shb-png/ece-362-project/ece-362-project-pcb.kicad_pcb

## KiCad design ece-362-project-pcb.kicad_pcb (2026-11-06)

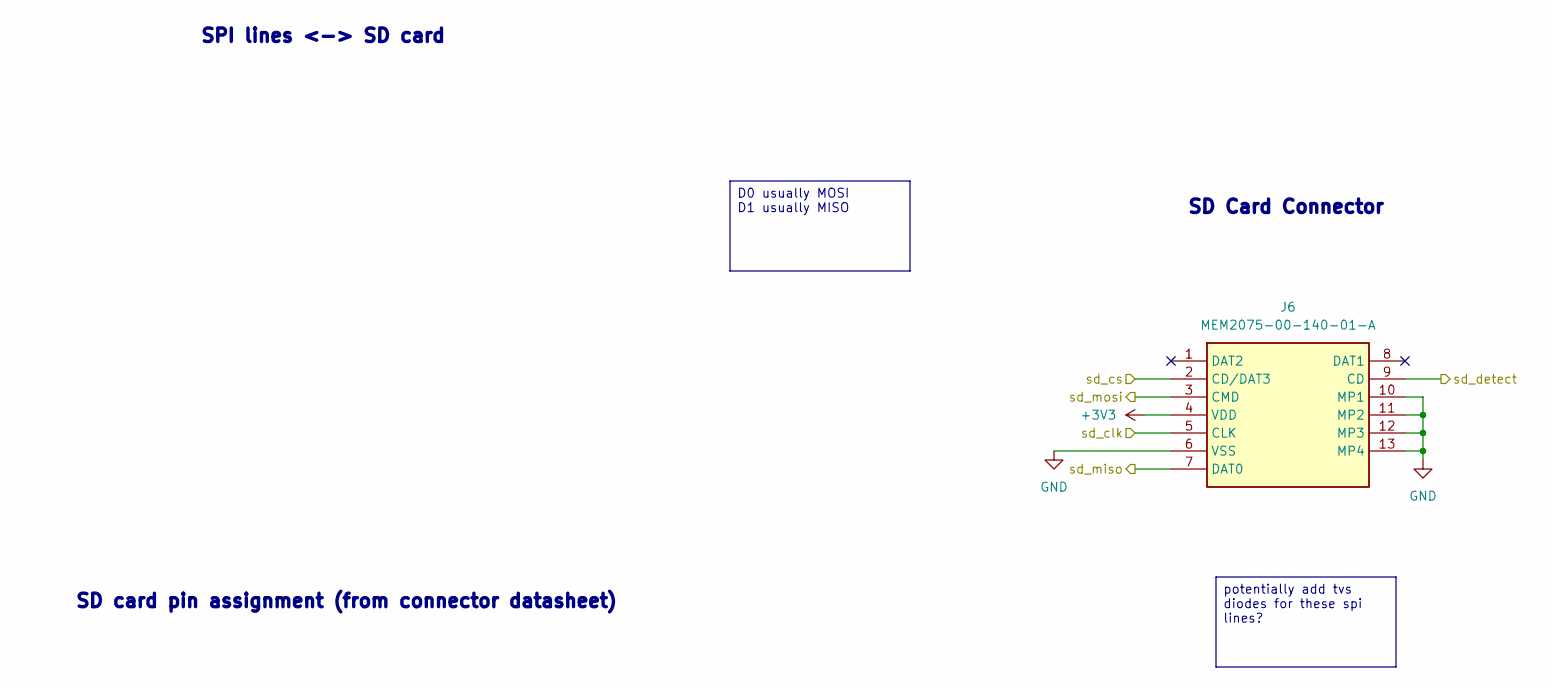
[picture p1: schematic sd_card.kicad_sch]

Parts:
J6: MEM2075-00-140-01-A; MEM20750014001A; Manufacturer_Part_Number MEM2075-00-140-01-A; Mouser Part Number 640-MEM20750014001A

Connections:
+3V3: J6.4 (VDD); also elsewhere on the board
/rp2350/sd_clk: J6.5 (CLK); also elsewhere on the board
/rp2350/sd_cs: J6.2 (CD/DAT3); also elsewhere on the board
/rp2350/sd_detect: J6.9 (CD); also elsewhere on the board
/rp2350/sd_miso: J6.7 (DAT0); also elsewhere on the board
/rp2350/sd_mosi: J6.3 (CMD); also elsewhere on the board
GND: J6.6 (VSS), J6.10 (MP1), J6.11 (MP2), J6.12 (MP3), J6.13 (MP4); also elsewhere on the board

Notes on the sheet:
SPI lines <-> SD card
SD card pin assignment (from connector datasheet)
SD Card Connector
potentially add tvs diodes for these spi lines?
D0 usually MOSI D1 usually MISO

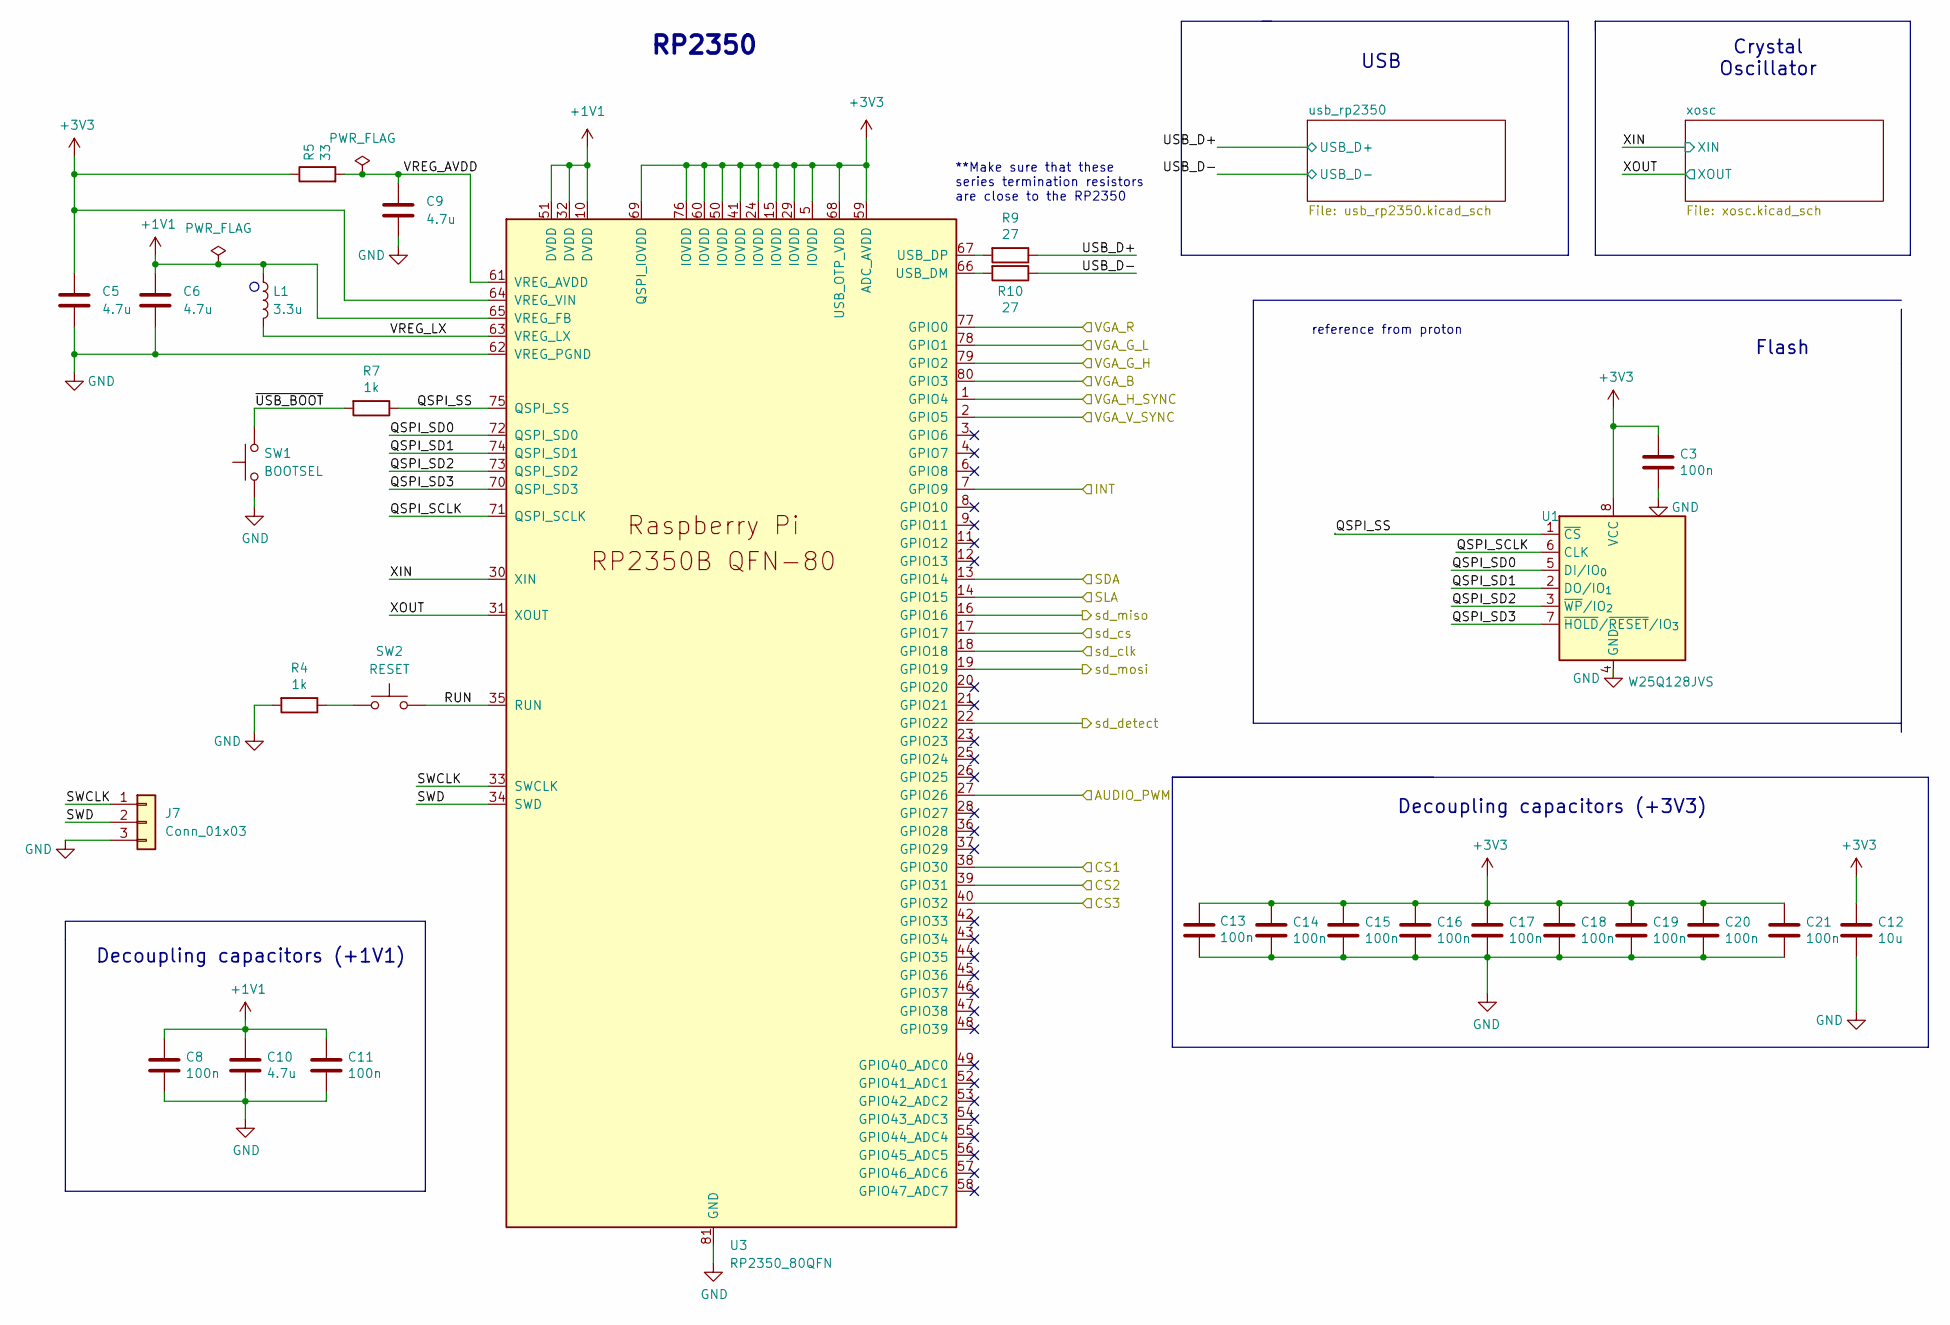
[picture p2: schematic rp2350.kicad_sch]

Parts:
C3, C8, C11, C13, C14, C15, C16, C17, C18, C19, C20, C21: 100n; C_0805_2012Metric; MPN CL05B104KP5VPNC
C5, C6, C9, C10: 4.7u; C_0805_2012Metric; MPN CL05A475MP5NRNC
C12: 10u; C_0805_2012Metric; MPN CL21A106KOQNNNE
J7: Conn_01x03; PinHeader_1x03_P2.54mm_Vertical
L1: 3.3u; L_0805_2012Metric_Pad1.05x1.20mm_HandSolder; MPN AOTA-B201610S3R3-101-T
R4, R7: 1k; R_0805_2012Metric_Pad1.20x1.40mm_HandSolder; MPN RC0402JR-071KL
R5: 33; R_0805_2012Metric_Pad1.20x1.40mm_HandSolder; MPN RC0402JR-0733RL
R9, R10: 27; R_0805_2012Metric_Pad1.20x1.40mm_HandSolder; MPN RC0402JR-0727RL
SW1: BOOTSEL; SW_SPST_PTS647_Sx38; MPN PTS647SM38SMTR2 LFS
SW2: RESET; SW_SPST_PTS647_Sx38; MPN PTS647SM38SMTR2 LFS
U1: W25Q128JVS; SOIC-8_5.3x5.3mm_P1.27mm
U3: RP2350_80QFN; QFN-80-1EP_10x10mm_P0.4mm_EP3.4x3.4mm; MPN SC1510-A4

Connections:
+1V1: C6.1, C8.1, C10.1, C11.1, L1.1, U3.10 (DVDD), U3.32 (DVDD), U3.51 (DVDD), U3.65 (VREG_FB)
+3V3: C3.1, C5.1, C12.1, C13.1, C14.1, C15.1, C16.1, C17.1, C18.1, C19.1, C20.1, C21.1, R5.1, U1.8 (VCC), U3.5 (IOVDD), U3.15 (IOVDD), U3.24 (IOVDD), U3.29 (IOVDD), U3.41 (IOVDD), U3.50 (IOVDD), U3.59 (ADC_AVDD), U3.60 (IOVDD), U3.64 (VREG_VIN), U3.68 (USB_OTP_VDD), U3.69 (QSPI_IOVDD), U3.76 (IOVDD); also elsewhere on the board
/audio/AUDIO_PWM: U3.27 (GPIO26); also elsewhere on the board
/capacitve_sensor/CS1: U3.38 (GPIO30); also elsewhere on the board
/capacitve_sensor/CS2: U3.39 (GPIO31); also elsewhere on the board
/capacitve_sensor/CS3: U3.40 (GPIO32); also elsewhere on the board
/capacitve_sensor/INT: U3.7 (GPIO9); also elsewhere on the board
/capacitve_sensor/SCL: U3.14 (GPIO15); also elsewhere on the board
/capacitve_sensor/SDA: U3.13 (GPIO14); also elsewhere on the board
/rp2350/QSPI_SCLK: U1.6 (CLK), U3.71 (QSPI_SCLK)
/rp2350/QSPI_SD0: U1.5 (DI/IO_{0}), U3.72 (QSPI_SD0)
/rp2350/QSPI_SD1: U1.2 (DO/IO_{1}), U3.74 (QSPI_SD1)
/rp2350/QSPI_SD2: U1.3 (~WP/IO_{2}), U3.73 (QSPI_SD2)
/rp2350/QSPI_SD3: U1.7 (~HOLD/~RESET/IO_{3}), U3.70 (QSPI_SD3)
/rp2350/QSPI_SS: R7.1, U1.1 (~CS), U3.75 (QSPI_SS)
/rp2350/RUN: SW2.2, U3.35 (RUN)
/rp2350/SWCLK: J7.1, U3.33 (SWCLK)
/rp2350/SWD: J7.2, U3.34 (SWD)
/rp2350/USB_D+: R9.1; also elsewhere on the board
/rp2350/USB_D-: R10.1; also elsewhere on the board
/rp2350/VGA_B: U3.80 (GPIO3); also elsewhere on the board
/rp2350/VGA_G_H: U3.79 (GPIO2); also elsewhere on the board
/rp2350/VGA_G_L: U3.78 (GPIO1); also elsewhere on the board
/rp2350/VGA_H_SYNC: U3.1 (GPIO4); also elsewhere on the board
/rp2350/VGA_R: U3.77 (GPIO0); also elsewhere on the board
/rp2350/VGA_V_SYNC: U3.2 (GPIO5); also elsewhere on the board
/rp2350/VREG_AVDD: C9.1, R5.2, U3.61 (VREG_AVDD)
/rp2350/VREG_LX: L1.2, U3.63 (VREG_LX)
/rp2350/XIN: U3.30 (XIN); also elsewhere on the board
/rp2350/XOUT: U3.31 (XOUT); also elsewhere on the board
/rp2350/sd_clk: U3.18 (GPIO18); also elsewhere on the board
/rp2350/sd_cs: U3.17 (GPIO17); also elsewhere on the board
/rp2350/sd_detect: U3.22 (GPIO22); also elsewhere on the board
/rp2350/sd_miso: U3.16 (GPIO16); also elsewhere on the board
/rp2350/sd_mosi: U3.19 (GPIO19); also elsewhere on the board
/rp2350/~USB_BOOT: R7.2, SW1.2
GND: C3.2, C5.2, C6.2, C8.2, C9.2, C10.2, C11.2, C12.2, C13.2, C14.2, C15.2, C16.2, C17.2, C18.2, C19.2, C20.2, C21.2, J7.3, R4.2, SW1.1, U1.4 (GND), U3.62 (VREG_PGND), U3.81 (GND); also elsewhere on the board
unnamed: R4.1, SW2.1
unnamed: R10.2, U3.66 (USB_DM)
unnamed: R9.2, U3.67 (USB_DP)

Notes on the sheet:
Crystal Oscillator
USB
reference from proton
Flash
RP2350
**Make sure that these series termination resistors are close to the RP2350
Decoupling capacitors (+3V3)
Decoupling capacitors (+1V1)

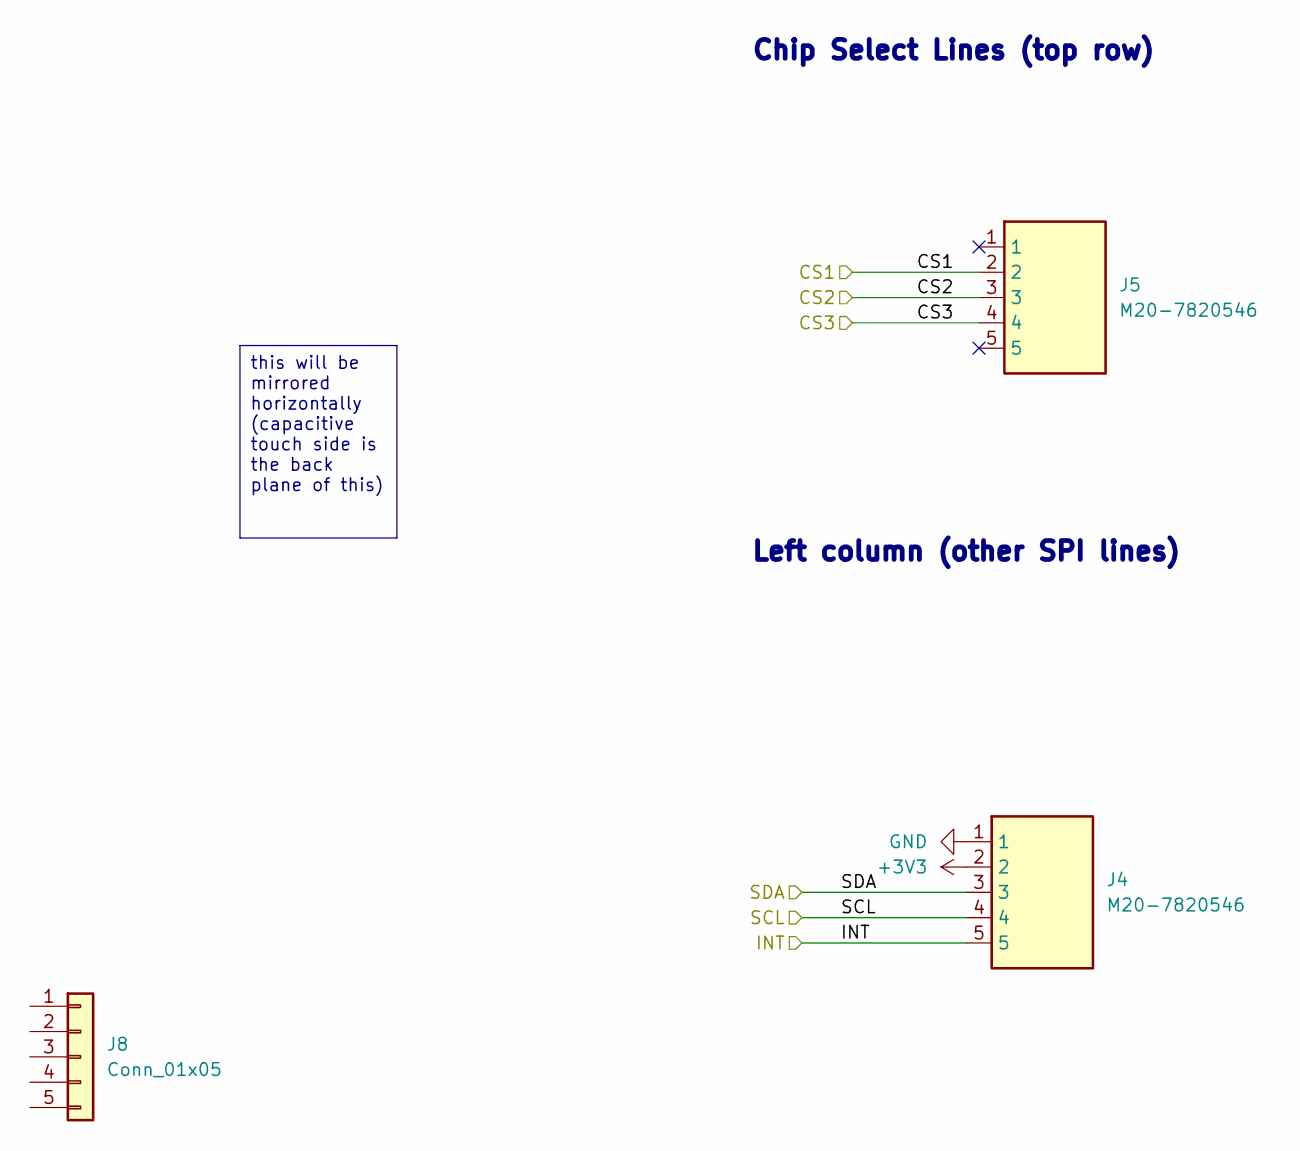
[picture p3: schematic capacitive_sensor.kicad_sch]

Parts:
J4, J5: M20-7820546; PinHeader_1x05_P2.54mm_Vertical; Manufacturer_Part_Number M20-7820546; Mouser Part Number 855-M20-7820546
J8: Conn_01x05; PinHeader_1x05_P2.54mm_Vertical

Connections:
+3V3: J4.2; also elsewhere on the board
/capacitve_sensor/CS1: J5.2; also elsewhere on the board
/capacitve_sensor/CS2: J5.3; also elsewhere on the board
/capacitve_sensor/CS3: J5.4; also elsewhere on the board
/capacitve_sensor/INT: J4.5; also elsewhere on the board
/capacitve_sensor/SCL: J4.4; also elsewhere on the board
/capacitve_sensor/SDA: J4.3; also elsewhere on the board
GND: J4.1; also elsewhere on the board

Notes on the sheet:
Left column (other SPI lines)
Chip Select Lines (top row)
this will be mirrored horizontally (capacitive touch side is the back plane of this)

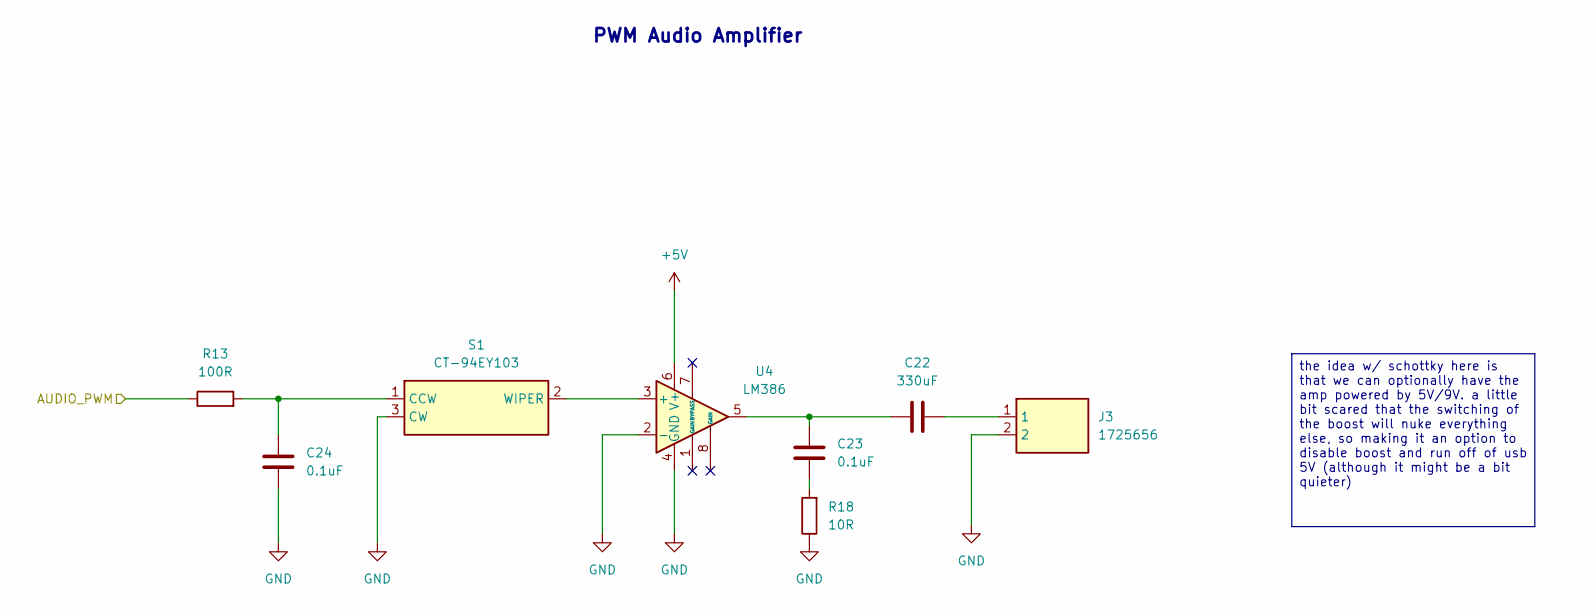
[picture p4: schematic audio.kicad_sch]

Parts:
C22: 330uF; C_0805_2012Metric
C23, C24: 0.1uF; C_0805_2012Metric
J3: 1725656; Manufacturer_Part_Number 1725656; Mouser Part Number 651-1725656
R13: 100R; R_0805_2012Metric_Pad1.20x1.40mm_HandSolder
R18: 10R; R_0805_2012Metric_Pad1.20x1.40mm_HandSolder
S1: CT-94EY103; CT94EY103; Manufacturer_Part_Number CT-94EY103; Mouser Part Number 229-CT-94EY103
U4: LM386; DIP-8_W7.62mm

Connections:
+5V: U4.6 (V+); also elsewhere on the board
/audio/AUDIO_PWM: R13.1; also elsewhere on the board
GND: C24.2, J3.2, R18.1, S1.3 (CW), U4.2 (-), U4.4 (GND); also elsewhere on the board
unnamed: C22.1, J3.1
unnamed: C22.2, C23.1, U4.5
unnamed: C23.2, R18.2
unnamed: C24.1, R13.2, S1.1 (CCW)
unnamed: S1.2 (WIPER), U4.3 (+)

Notes on the sheet:
PWM Audio Amplifier
the idea w/ schottky here is that we can optionally have the amp powered by 5V/9V. a little bit scared that the switching of the boost will nuke everything else, so making it an option to disable boost and run off of usb 5V (although it might be a bit quieter)

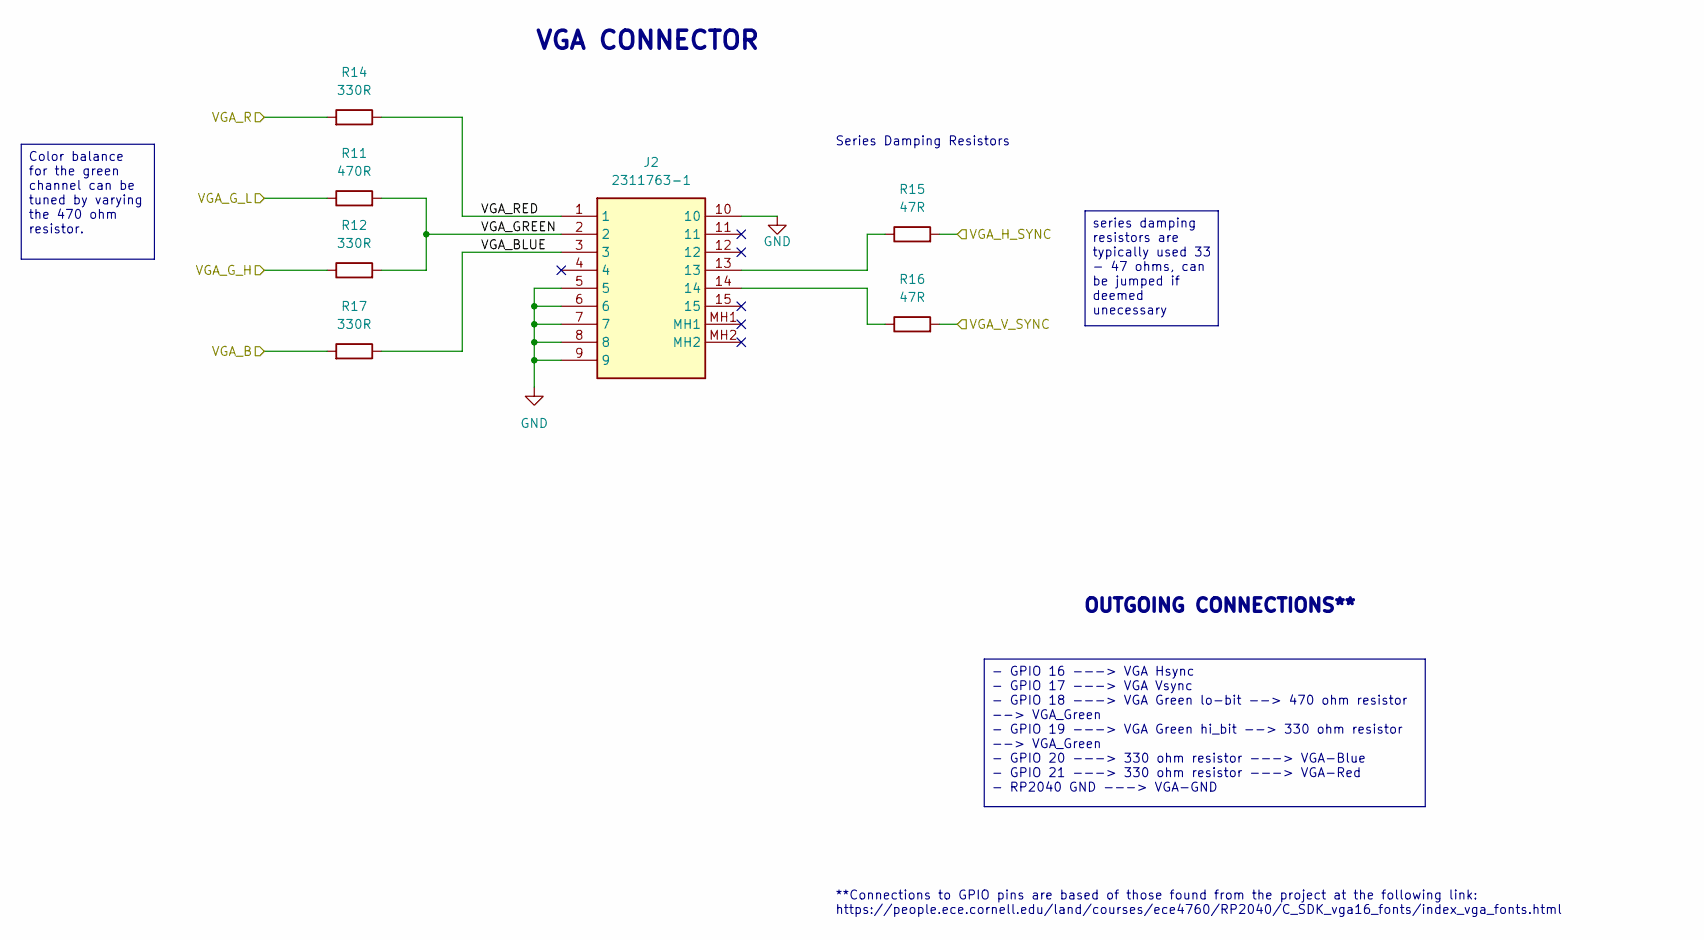
[picture p5: schematic vga.kicad_sch]

Parts:
J2: 2311763-1; 23117631; Manufacturer_Part_Number 2311763-1; Mouser Part Number 571-2311763-1
R11: 470R; R_0805_2012Metric_Pad1.20x1.40mm_HandSolder
R12, R14, R17: 330R; R_0805_2012Metric_Pad1.20x1.40mm_HandSolder
R15, R16: 47R; R_0805_2012Metric_Pad1.20x1.40mm_HandSolder

Connections:
/rp2350/VGA_B: R17.2; also elsewhere on the board
/rp2350/VGA_G_H: R12.1; also elsewhere on the board
/rp2350/VGA_G_L: R11.1; also elsewhere on the board
/rp2350/VGA_H_SYNC: R15.2; also elsewhere on the board
/rp2350/VGA_R: R14.2; also elsewhere on the board
/rp2350/VGA_V_SYNC: R16.2; also elsewhere on the board
/vga/VGA_BLUE: J2.3, R17.1
/vga/VGA_GREEN: J2.2, R11.2, R12.2
/vga/VGA_RED: J2.1, R14.1
GND: J2.5, J2.6, J2.7, J2.8, J2.9, J2.10; also elsewhere on the board
unnamed: J2.13, R15.1
unnamed: J2.14, R16.1

Notes on the sheet:
OUTGOING CONNECTIONS**
**Connections to GPIO pins are based of those found from the project at the following link: https://people.ece.cornell.edu/land/courses/ece4760/RP2040/C_SDK_vga16_fonts/index_vga_fonts.html
VGA CONNECTOR
Series Damping Resistors
series damping resistors are typically used 33 - 47 ohms, can be jumped if deemed unecessary
Color balance for the green channel can be tuned by varying the 470 ohm resistor.
- GPIO 16 ---> VGA Hsync - GPIO 17 ---> VGA Vsync - GPIO 18 ---> VGA Green lo-bit --> 470 ohm resistor --> VGA_Green - GPIO 19 ---> VGA Green hi_bit --> 330 ohm resistor --> VGA_Green - GPIO 20 ---> 330 ohm resistor ---> VGA-Blue - GPIO 21 ---> 330 ohm resistor ---> VGA-Red - RP2040 GND ---> VGA-GND

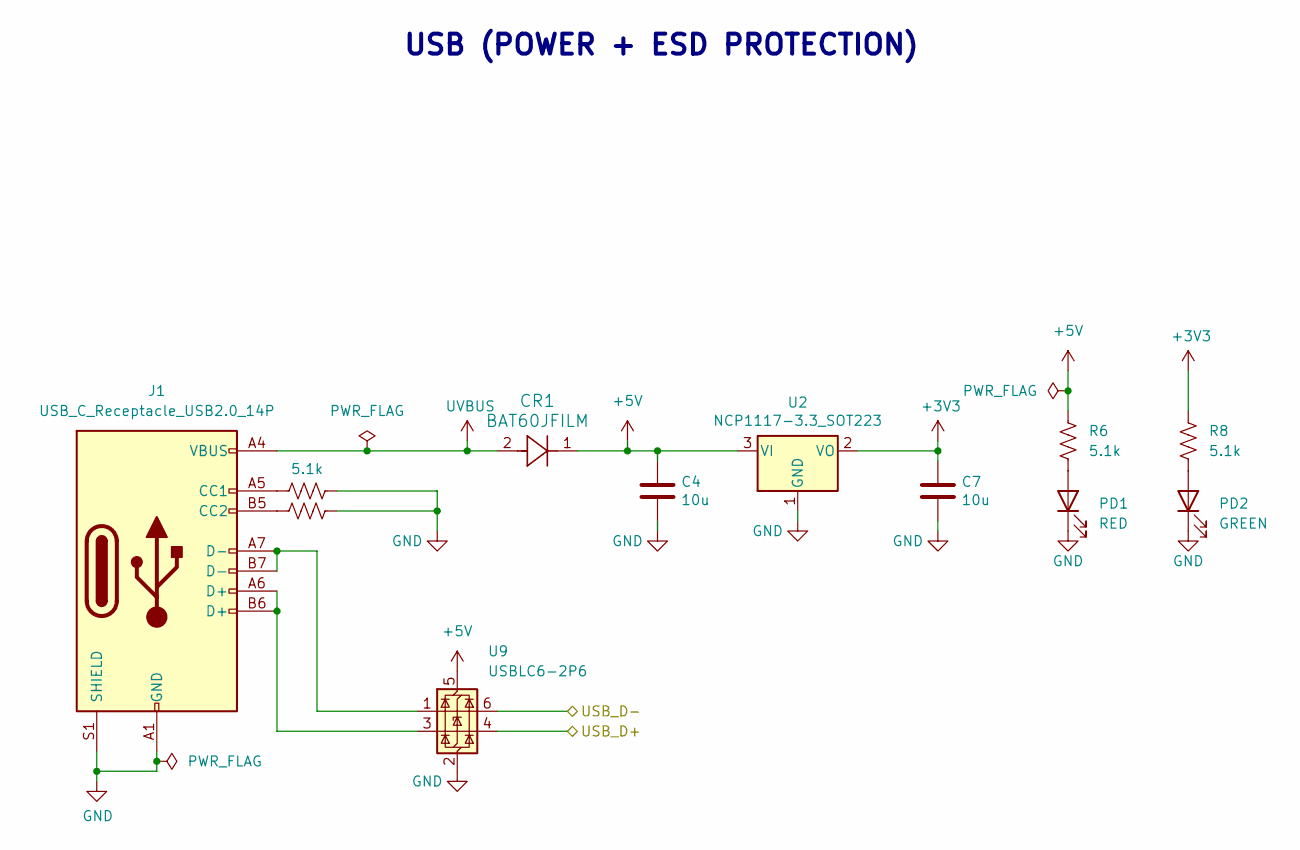
[picture p6: schematic usb_rp2350.kicad_sch]

Parts:
C4, C7: 10u; C_0805_2012Metric; MPN CL21A106KOQNNNE
CR1: BAT60JFILM; D_SOD-323_HandSoldering; MPN BAT60A-TR
J1: USB_C_Receptacle_USB2.0_14P; USB_C_Receptacle_G-Switch_GT-USB-7010ASV; MPN UJ20-C-H-G-SMT-1-P16-TR
PD1: RED; LED_0805_2012Metric; MPN LS R976-NR-1-0-20-R18
PD2: GREEN; LED_0805_2012Metric; MPN LG R971-KN-1-0-20-R18
R1, R2, R6, R8: 5.1k; R_0805_2012Metric_Pad1.20x1.40mm_HandSolder; MPN RK73H1ETTP5101F
U2: NCP1117-3.3_SOT223; SOT-223-3_TabPin2; MPN NCP1117LPST33T3G
U9: USBLC6-2P6; SOT-666; MPN USBLC6-2P6

Connections:
+3V3: C7.1, R8.1, U2.2 (VO); also elsewhere on the board
+5V: C4.1, CR1.1, R6.1, U2.3 (VI), U9.5 (VBUS); also elsewhere on the board
/rp2350/USB_D+: U9.4 (I/O2); also elsewhere on the board
/rp2350/USB_D-: U9.6 (I/O1); also elsewhere on the board
GND: C4.2, C7.2, J1.A1 (GND), J1.A12 (GND), J1.B1 (GND), J1.B12 (GND), J1.S1 (SHIELD), PD1.1 (K), PD2.1 (K), R1.2, R2.2, U2.1 (GND), U9.2 (GND); also elsewhere on the board
unnamed: J1.A5 (CC1), R1.1
unnamed: J1.B5 (CC2), R2.1
unnamed: J1.A6 (D+), J1.B6 (D+), U9.3 (I/O2)
unnamed: J1.A7 (D-), J1.B7 (D-), U9.1 (I/O1)
unnamed: PD1.2 (A), R6.2
unnamed: PD2.2 (A), R8.2
UVBUS: CR1.2, J1.A4 (VBUS), J1.A9 (VBUS), J1.B4 (VBUS), J1.B9 (VBUS)

Notes on the sheet:
USB (POWER + ESD PROTECTION)

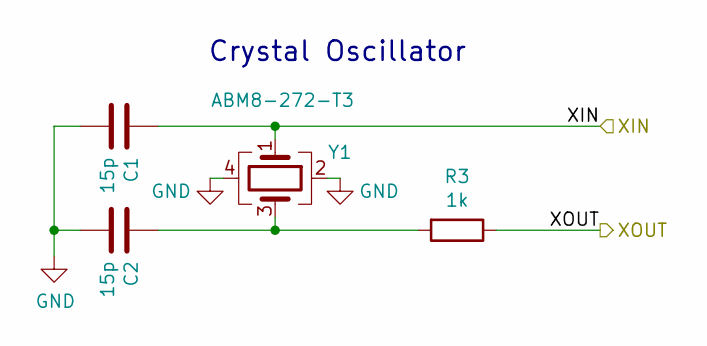
[picture p7: schematic xosc.kicad_sch]

Parts:
C1, C2: 15p; C_0805_2012Metric; MPN GJM1555C1H150GB01D
R3: 1k; R_0805_2012Metric_Pad1.20x1.40mm_HandSolder; MPN RC0402JR-071KL
Y1: ABM8-272-T3; Crystal_SMD_3225-4Pin_3.2x2.5mm; MPN ABM8-272-T3

Connections:
/rp2350/XIN: C1.1, Y1.1; also elsewhere on the board
/rp2350/XOUT: R3.1; also elsewhere on the board
GND: C1.2, C2.2, Y1.2, Y1.4; also elsewhere on the board
unnamed: C2.1, R3.2, Y1.3

Notes on the sheet:
Crystal Oscillator

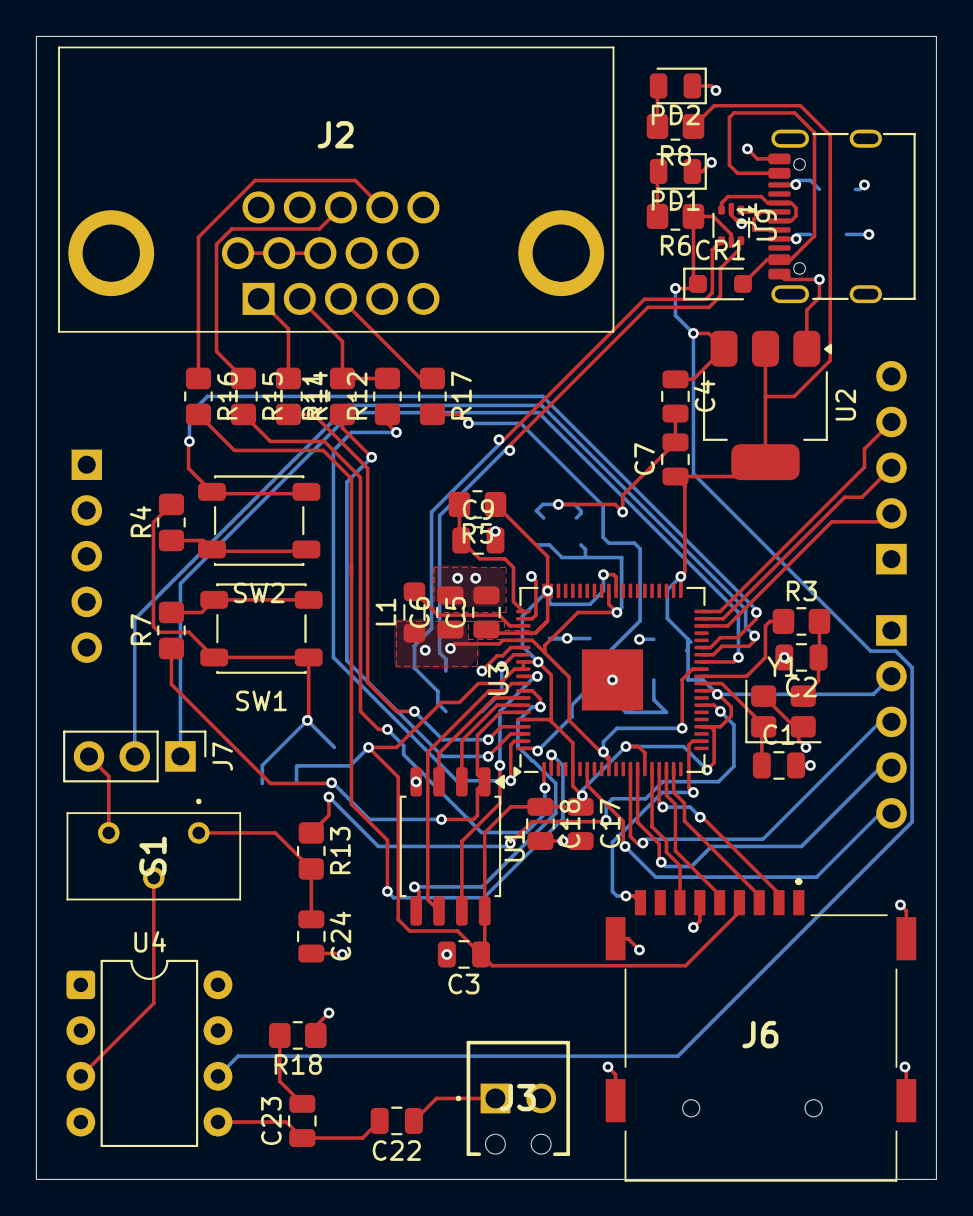
[picture p8: board ece-362-project-pcb.kicad_pcb from above]

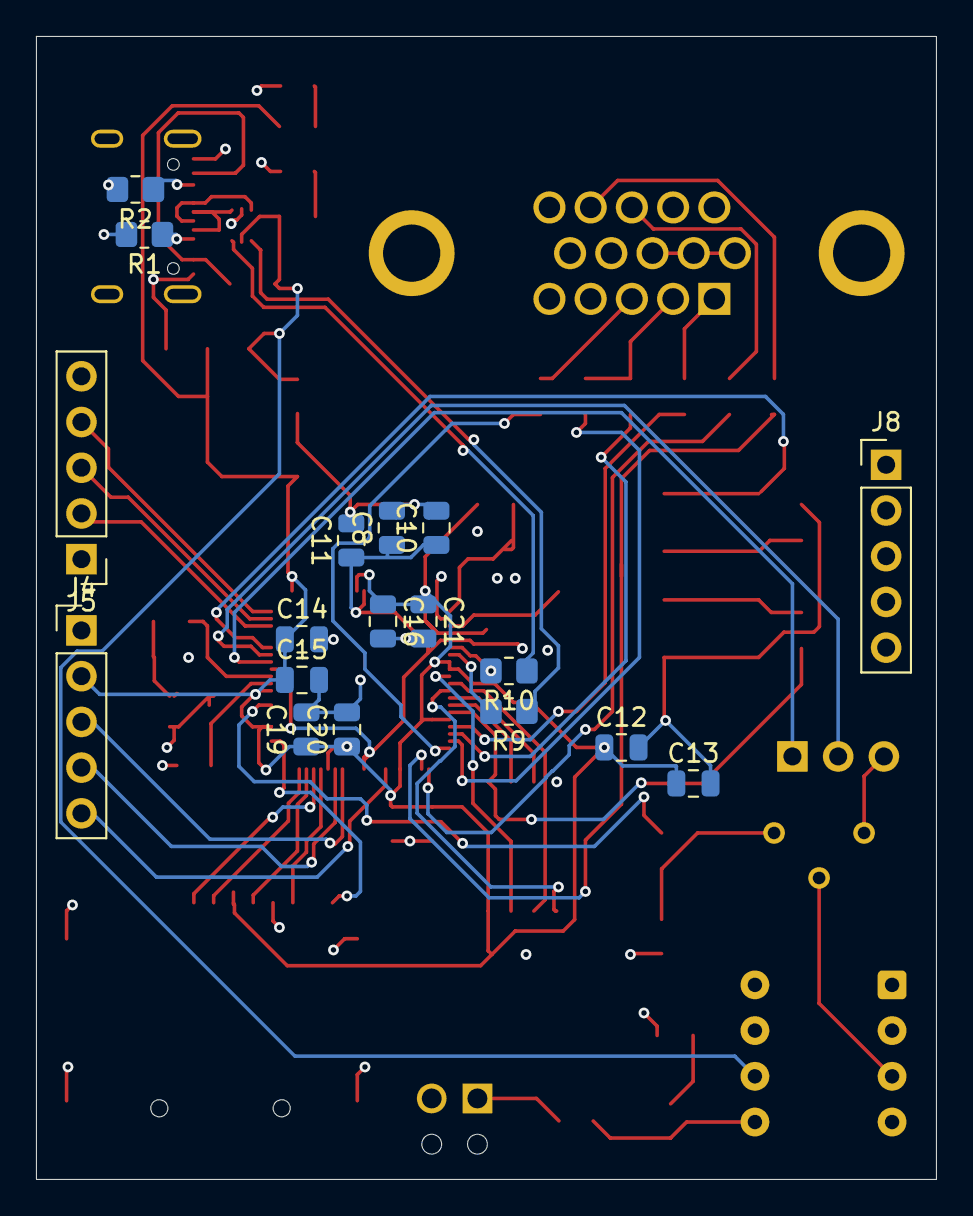
[picture p9: board ece-362-project-pcb.kicad_pcb from below]

Board: 4 copper layers, 50.0 x 63.5 mm, 63 parts (18 on the bottom side), 59 nets.
