shb-png/ece-362-project/(commit log)

2026-11-03 basic sheet hierarchy + rp2350 symbol import
    [audio.kicad_sch, capacitive_sensor.kicad_sch, connectors.kicad_sch, ece-362-project-pcb.kicad_sch, rp2350.kicad_sch, sd_card.kicad_sch, vga.kicad_sch]
2026-11-03 subsheet components added
    [audio.kicad_sch, capacitive_sensor.kicad_sch, ece-362-project-pcb.kicad_sch, rp2350.kicad_sch, sd_card.kicad_sch, usb_rp2350.kicad_sch, vga.kicad_sch, xosc.kicad_sch]
2026-11-03 top sheet connections
    [ece-362-project-pcb.kicad_sch, rp2350.kicad_sch]
2026-11-04 erc/drc no big red errors
    [audio.kicad_sch, capacitive_sensor.kicad_sch, ece-362-project-pcb.kicad_pcb, ece-362-project-pcb.kicad_sch, rp2350.kicad_sch, usb_rp2350.kicad_sch, vga.kicad_sch, xosc.kicad_sch]
2026-11-04 drc diddling
    [ece-362-project-pcb.kicad_pcb, rp2350.kicad_sch]
2026-11-06 fixed a couples of traces on both sides
    [ece-362-project-pcb.kicad_pcb]
2026-11-06 fixed diff pair, debug, 1v1 ind
    [ece-362-project-pcb.kicad_pcb, rp2350.kicad_sch]
2026-11-06 more changes
    [ece-362-project-pcb.kicad_pcb, rp2350.kicad_sch]
2026-11-06 final changes, no drc errors
    [capacitive_sensor.kicad_sch, ece-362-project-pcb.kicad_pcb]
2026-11-06 fixed diff pair
    [ece-362-project-pcb.kicad_pcb]
